whitehaven/wild-harp-build/presite_checklist.md

# Base Checklist

To be completed before leaving to the airfield.

## Materials

- [ ] plane body, fully assembled
- [ ] primary battery
- [ ] Radio control
  - [ ] battery
- [ ] FPV goggles
  - [ ] battery
- [ ] laptop
- [ ] SiK transmitter

### Optional

- [ ] charger
  - [ ] appropriate `XT60` hookup leads
- [ ] 12V support battery
  - [ ] appropriate `XT60` hookup leads
- [ ] car battery terminal leads
  - [ ] appropriate `XT60` hookup leads
- [ ] USB-C cable

## Flight plan

- [ ] Weather/conditions checked and permissible
- [ ] Flight registered via LAANC
