whitehaven/wild-harp-build/airframe/nose/nose mount.SLDPRT

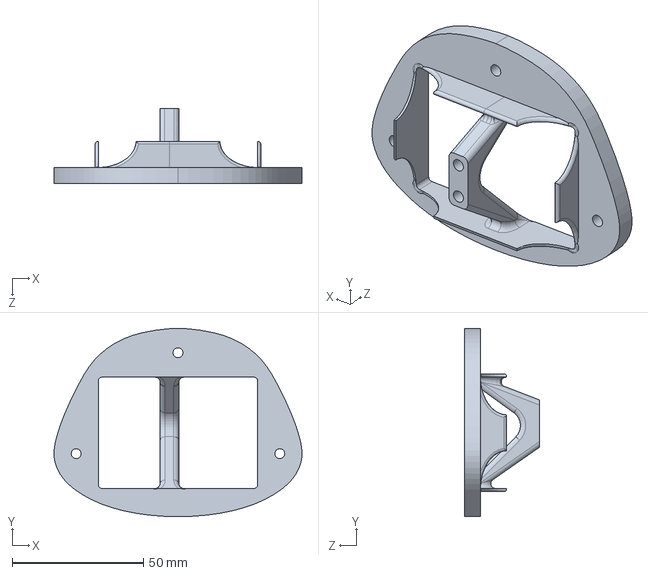
[picture p1: CAD file, 2024-09-02]
airframe/nose/nose mount.SLDPRT
94.3 x 71.6 x 28.4 mm
