whitehaven/wild-harp-build/fc_system/F405_mount.step

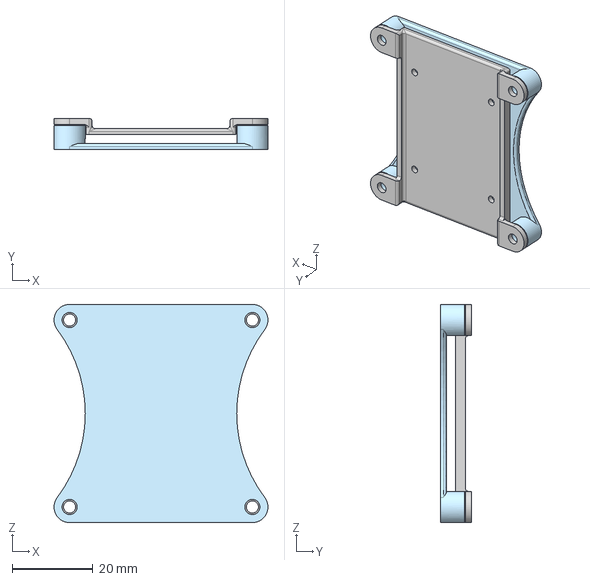
[picture p2: CAD file, 2024-07-30]
fc_system/F405_mount.step
53.0 x 7.73 x 54.1 mm
