whitehaven/wild-harp-build/fpv_system/vtx mount.SLDPRT

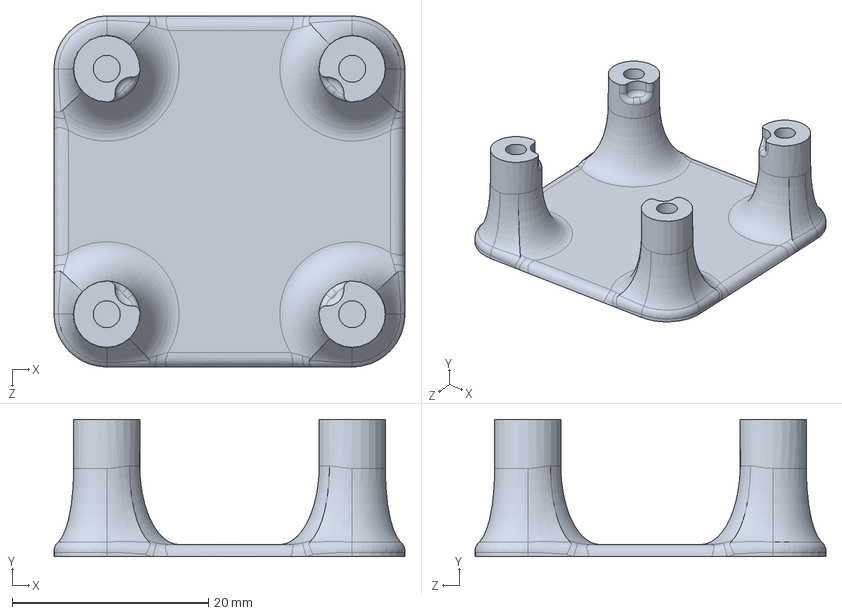
[picture p3: CAD file, 2024-08-24]
fpv_system/vtx mount.SLDPRT
35.8 x 14.0 x 35.8 mm
