whitehaven/wild-harp-build/airframe/motor_mount/spacer.SLDPRT

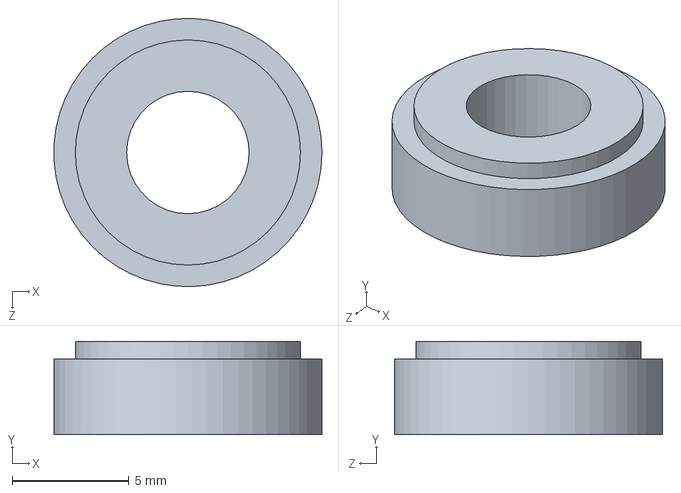
[picture p4: CAD file, 2024-08-18]
airframe/motor_mount/spacer.SLDPRT
11.5 x 4.00 x 11.5 mm
