whitehaven/wild-harp-build/airframe/nose/beak elliptical nose.SLDPRT

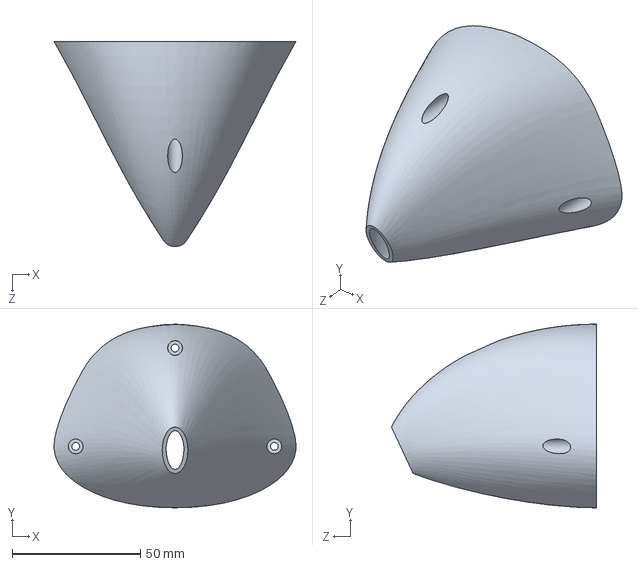
[picture p5: CAD file, 2024-09-01]
airframe/nose/beak elliptical nose.SLDPRT
94.4 x 71.6 x 80.0 mm
