whitehaven/wild-harp-build/fpv_system/camera mount.SLDPRT

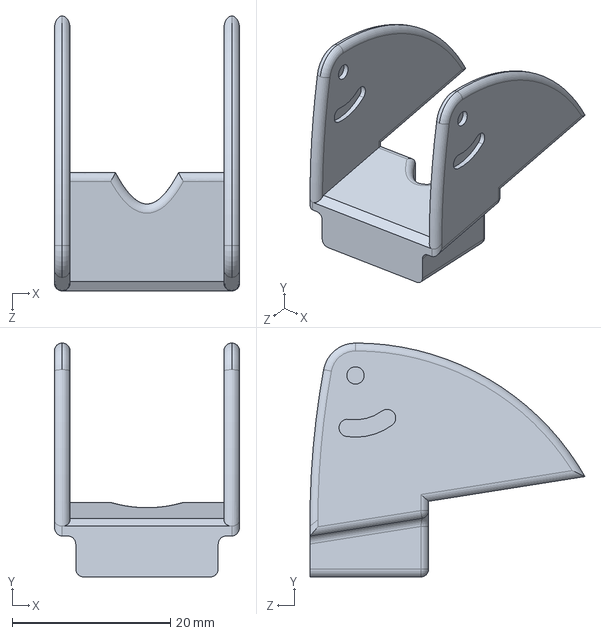
[picture p6: CAD file, 2024-08-01]
fpv_system/camera mount.SLDPRT
23.4 x 29.6 x 34.8 mm
