whitehaven/wild-harp-build/(list of files, cad)

Other CAD files:
airframe/nose/nose assembly.SLDASM
airframe/motor_mount/motor mount open.sldprt
airframe/motor_mount/motor mount open.3mf
airframe/motor_mount/spacer.3MF
airframe/nose/beak elliptical nose.3MF
airframe/nose/nose mount pattern.SLDDRW
airframe/nose/nose mount.3MF
fc_system/F405_mount.3mf
fpv_system/camera mount.3MF
fpv_system/vtx mount.3MF
