whitehaven/wild-harp-build/airframe/nose/nose mount pattern.pdf

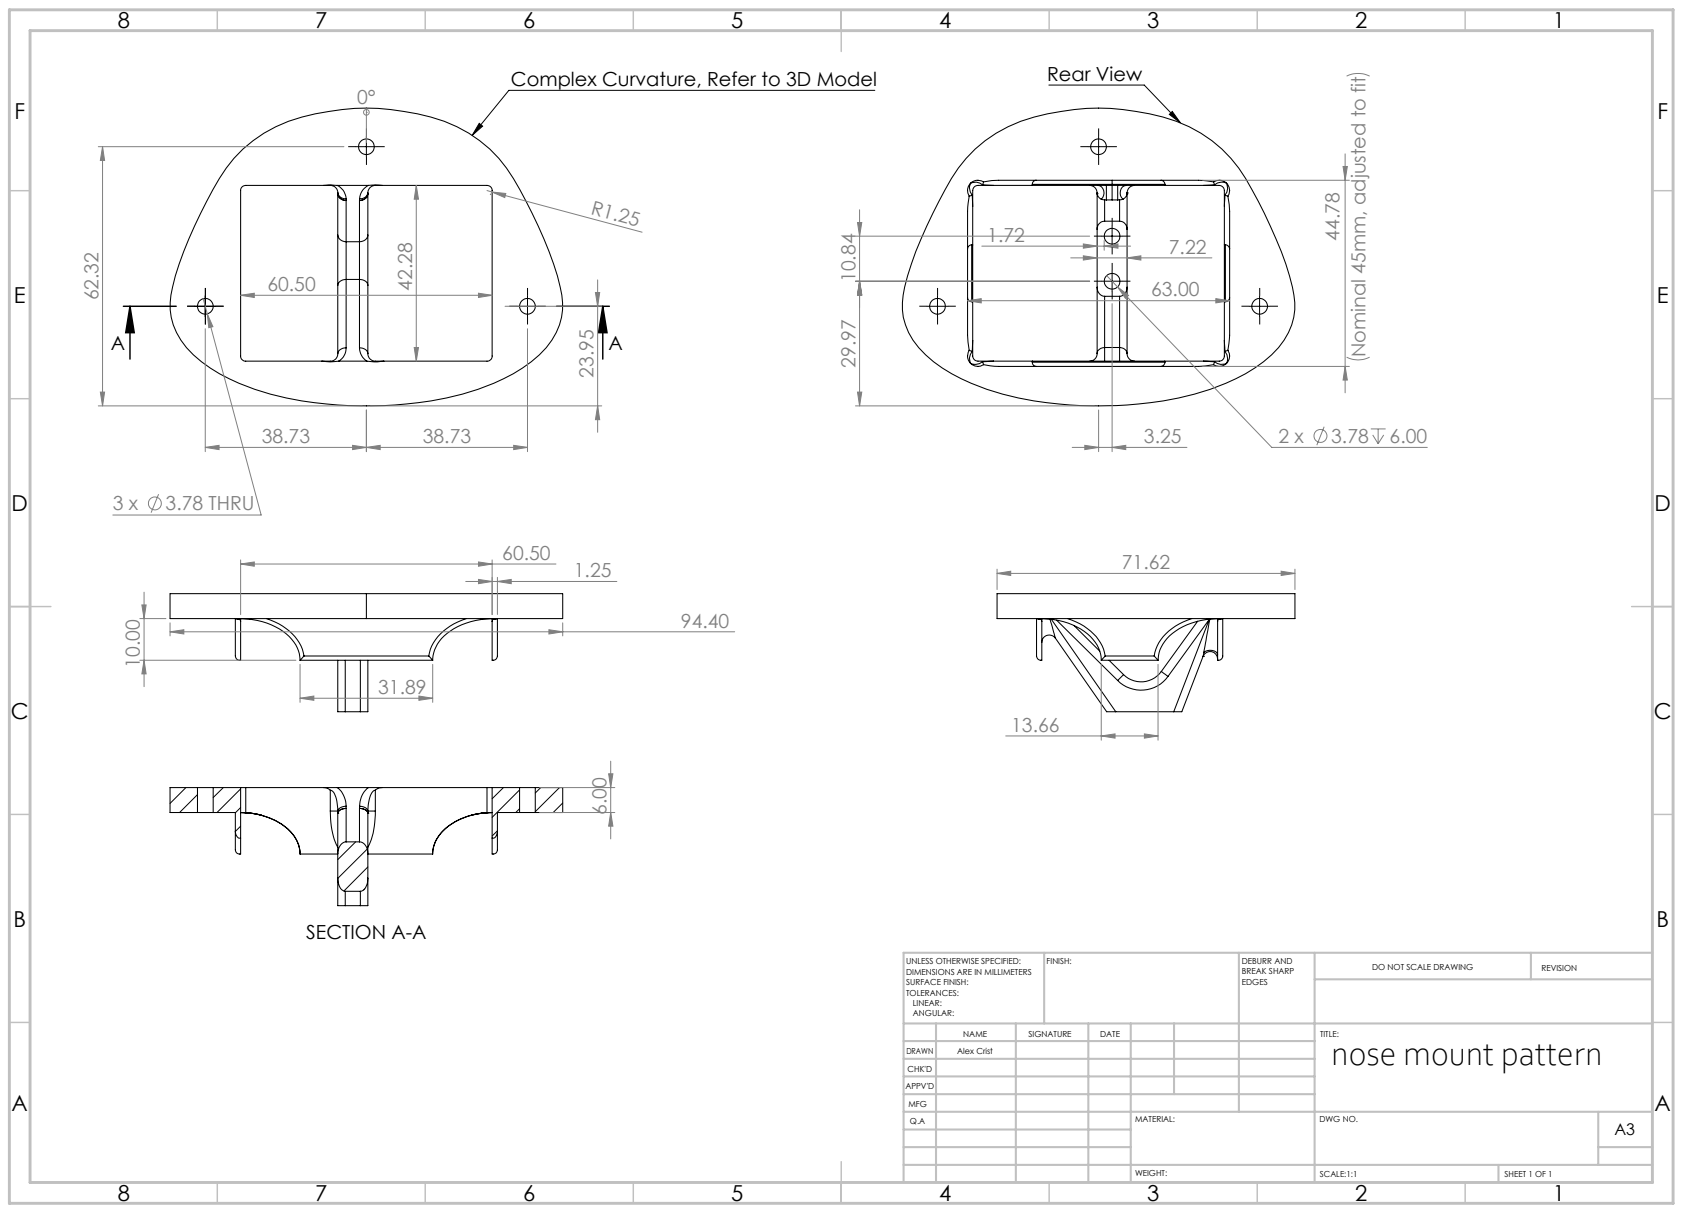
[picture p7: page 1]
3 x 3.78 THRU; Rear View; SECTION A-A; FINISH:; DEBURR AND; BREAK SHARP; DO NOT SCALE DRAWING; REVISION; SCALE:1:1; SHEET 1 OF 1

Complex Curvature, Refer to 3D Model

Nominal 45mm, adjusted to fit

UNLESS OTHERWISE SPECIFIED:
DIMENSIONS ARE IN MILLIMETERS
SURFACE FINISH:
TOLERANCES:
LINEAR:
ANGULAR:

DRAWN | Alex Crist

NAME | SIGNATURE | DATE | | | | TITLE: nose mount pattern

CHK'D
APPV'D
MFG
Q.A | | | | MATERIAL: | DWG NO. | A3
