whitehaven/wild-harp-build/avionics/ardupilot_wild_harp.param

BATT_AMP_OFFSET,0
BATT_AMP_PERVLT,50
BATT_ARM_MAH,0
BATT_ARM_VOLT,0
BATT_CAPACITY,3300
BATT_CRT_MAH,0
BATT_CRT_VOLT,0
BATT_CURR_PIN,11
BATT_FS_CRT_ACT,0
BATT_FS_LOW_ACT,1
BATT_FS_VOLTSRC,0
BATT_LOW_MAH,200
BATT_LOW_TIMER,10
BATT_LOW_VOLT,0
BATT_MONITOR,4
BATT_OPTIONS,0
BATT_SERIAL_NUM,-1
BATT_VLT_OFFSET,0
BATT_VOLT_MULT,11.05
BATT_VOLT_PIN,10
BATT2_MONITOR,0
BATT3_MONITOR,0
BATT4_MONITOR,0
BATT5_MONITOR,0
BATT6_MONITOR,0
BATT7_MONITOR,0
BATT8_MONITOR,0
BATT9_MONITOR,0
FLTMODE_CH,11
FLTMODE_GCSBLOCK,0
FLTMODE1,5
FLTMODE2,7
FLTMODE3,4
FLTMODE4,12
FLTMODE5,13
FLTMODE6,0
INS_GYRO_FILTER,20
INS_HNTCH_ENABLE,0
SERIAL0_BAUD,115
SERIAL0_PROTOCOL,2
SERIAL1_BAUD,57
SERIAL1_OPTIONS,0
SERIAL1_PROTOCOL,23
SERIAL2_BAUD,57
SERIAL2_OPTIONS,0
SERIAL2_PROTOCOL,2
SERIAL3_BAUD,230
SERIAL3_OPTIONS,0
SERIAL3_PROTOCOL,5
SERIAL4_BAUD,57
SERIAL4_OPTIONS,0
SERIAL4_PROTOCOL,2
SERIAL5_BAUD,115
SERIAL5_OPTIONS,0
SERIAL5_PROTOCOL,42
SERIAL6_BAUD,57
SERIAL6_OPTIONS,0
SERIAL6_PROTOCOL,2
SERVO1_FUNCTION,70
SERVO1_MAX,2000
SERVO1_MIN,1000
SERVO1_REVERSED,0
SERVO1_TRIM,1000
SERVO2_FUNCTION,0
SERVO2_MAX,1900
SERVO2_MIN,1100
SERVO2_REVERSED,0
SERVO2_TRIM,1500
SERVO3_FUNCTION,78
SERVO3_MAX,2000
SERVO3_MIN,1000
SERVO3_REVERSED,1
SERVO3_TRIM,1503
SERVO4_FUNCTION,77
SERVO4_MAX,2000
SERVO4_MIN,1000
SERVO4_REVERSED,0
SERVO4_TRIM,1445
SERVO5_FUNCTION,0
SERVO5_MAX,1900
SERVO5_MIN,1100
SERVO5_REVERSED,0
SERVO5_TRIM,1500
SERVO6_FUNCTION,0
SERVO6_MAX,1900
SERVO6_MIN,1100
SERVO6_REVERSED,0
SERVO6_TRIM,1500
SERVO7_FUNCTION,0
SERVO7_MAX,1900
SERVO7_MIN,1100
SERVO7_REVERSED,0
SERVO7_TRIM,1500
SERVO8_FUNCTION,0
SERVO8_MAX,1900
SERVO8_MIN,1100
SERVO8_REVERSED,0
SERVO8_TRIM,1500
SERVO9_FUNCTION,0
SERVO9_MAX,1900
SERVO9_MIN,1100
SERVO9_REVERSED,0
SERVO9_TRIM,1500
