whitehaven/wild-harp-build/radiomaster_boxer_config/model00.yml

semver: 2.8.4
header: 
   name: "Wild Harp"
timers: 
   0:
      start: 0
      swtch: "NONE"
      value: 4185
      mode: OFF
      countdownBeep: 0
      minuteBeep: 0
      persistent: 0
      countdownStart: 0
      showElapsed: 0
      name: ""
telemetryProtocol: 0
thrTrim: 0
noGlobalFunctions: 0
displayTrims: 0
ignoreSensorIds: 0
trimInc: 0
disableThrottleWarning: 0
displayChecklist: 0
extendedLimits: 1
extendedTrims: 0
throttleReversed: 0
enableCustomThrottleWarning: 0
disableTelemetryWarning: 0
customThrottleWarningPosition: 0
beepANACenter: 0
mixData: 
 -
   weight: 100
   destCh: 0
   srcRaw: I3
   carryTrim: 0
   mixWarn: 0
   mltpx: ADD
   offset: 0
   swtch: "NONE"
   flightModes: 000000000
   delayUp: 0
   delayDown: 0
   speedUp: 0
   speedDown: 0
   name: ""
 -
   weight: 100
   destCh: 1
   srcRaw: I1
   carryTrim: 0
   mixWarn: 0
   mltpx: ADD
   offset: 0
   swtch: "NONE"
   flightModes: 000000000
   delayUp: 0
   delayDown: 0
   speedUp: 0
   speedDown: 0
   name: ""
 -
   weight: 100
   destCh: 2
   srcRaw: I2
   carryTrim: 0
   mixWarn: 0
   mltpx: ADD
   offset: 0
   swtch: "NONE"
   flightModes: 000000000
   delayUp: 0
   delayDown: 0
   speedUp: 0
   speedDown: 0
   name: ""
 -
   weight: 100
   destCh: 3
   srcRaw: I0
   carryTrim: 0
   mixWarn: 0
   mltpx: ADD
   offset: 0
   swtch: "NONE"
   flightModes: 000000000
   delayUp: 0
   delayDown: 0
   speedUp: 0
   speedDown: 0
   name: ""
 -
   weight: 100
   destCh: 4
   srcRaw: SA
   carryTrim: 0
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
   2:
      val: 85
   3:
      val: -11
   4:
      val: 33
   156:
      val: -100
   159:
      val: 100
   160:
      val: -2
   161:
      val: 2
thrTraceSrc: Thr
switchWarningState: AuBuCuDuEuFu
rssiSource: none
rfAlarms: 
   warning: 45
   critical: 42
thrTrimSw: 0
potsWarnMode: WARN_OFF
jitterFilter: ON
moduleData: 
   0:
      type: TYPE_CROSSFIRE
      subType: 0
      channelsStart: 0
      channelsCount: 16
      failsafeMode: NOT_SET
      mod: 
         crsf: 
            telemetryBaudrate: 0
inputNames: 
   0:
      val: "Rud"
   1:
      val: "Ele"
   2:
      val: "Thr"
   3:
      val: "Ail"
   4:
      val: "P1"
   5:
      val: "P2"
   6:
      val: "Mod"
potsWarnEnabled: 0
screens: 
   0:
      type: SCRIPT
      u: 
         script: 
            file: "yaapu7"
view: 0
modelRegistrationID: "*\x15*\x15!\x03%\x07"
