whitehaven/wild-harp-build/(commit log)

2024-07-30 Add first dump of ardupilot params
    [ardupilot_wild_harp.param]
2024-07-30 added CAD files for FC mount
    [hive_mount.3mf, hive_mount.step]
2024-08-01 reorganize to avionics
    [ardupilot_wild_harp.param]
2024-08-01 reorganize to fc_sysystem
    [F405_mount.3mf, F405_mount.step]
2024-08-01 completed VTX mount, printed succesfully
    [VTX_mount.step, VTX_mount.x_t]
2024-08-01 completed and printed camera mount
    [camera mount.3MF, camera mount.SLDPRT, camera mount.STEP]
2024-08-02 rebuilt and correctly configured servos
    [ardupilot_wild_harp.param]
2024-08-09 add message to OSD, doesn't look right
    [ardupilot_wild_harp.param]
2024-08-09 add BLHeli_s passthrough support
    [ardupilot_wild_harp.param]
2024-08-09 shorter/closer takeoff
    [ardupilot_wild_harp.param]
2024-08-09 add utility file to allow esc passthrough
    [ardupilot_wild_harp_dshot_access.param]
2024-08-11 add SW base file for vtx mount which was missed
    [vtx mount.SLDPRT]
2024-08-18 added missing 3MF files
    [F405_mount.3mf, vtx mount.3MF]
2024-08-18 OSD reformat for smaller screen which was showing up
    [ardupilot_wild_harp.param]
2024-08-18 FC control of VTX enabled, unclear if working yet
    [ardupilot_wild_harp.param]
2024-08-18 initial tkoff/landing settings tried
    [ardupilot_wild_harp.param]
2024-08-18 final control settings before maiden 01
    [ardupilot_wild_harp.param]
2024-08-18 return to PMW ESC control
    [ardupilot_wild_harp.param]
2024-08-18 upgraded shorter VTX mount with correct contours for 20x20 protrusions
    [vtx mount.3MF, vtx mount.SLDPRT]
2024-08-18 spacer for pusher prop mounting
    [spacer.3MF, spacer.SLDPRT]
2024-08-21 add radio configuration
    [BOXER.cfg]
2024-08-24 PIDs from first tuning
    [ardupilot_wild_harp.param]
2024-08-24 working osd/vtx settings
    [ardupilot_wild_harp.param]
2024-08-24 odds and ends settings from flight 002, status update
    [ardupilot_wild_harp.param]
2024-08-24 new new VTX
    [vtx mount.SLDPRT]
2024-08-28 deactivate airspeed sensor for now
    [ardupilot_wild_harp.param]
2024-08-28 terrain enabled with sizing, untested as yet
    [ardupilot_wild_harp.param]
2024-08-29 ADC on for this profile only
2024-09-01 add FDM nose mount and beak-ellipse nose
    [beak elliptical nose.3MF, beak elliptical nose.SLDPRT, nose assembly.SLDASM, nose mount.3MF, nose mount.SLDPRT]
2024-09-01 flight log 2024-09-01
    [ardupilot_wild_harp.param]
2024-09-01 OSD refomat for better spacing and wind estimation
    [ardupilot_wild_harp.param]
2024-09-02 9/2 update including nose mount spec added
    [nose mount pattern.SLDDRW, nose mount.SLDPRT]
2024-09-02 remove derivative VTX modeling files missed from earlier
    [VTX_mount.step, VTX_mount.x_t, camera mount.STEP]
2024-09-06 9/3 flight and changes
    [ardupilot_wild_harp.param]
2024-09-07 new MAGfit calibration to fix persistent orientation error
    [ardupilot_wild_harp.param]
2024-09-07 replace FBWB with Cruise mode
    [ardupilot_wild_harp.param]
2024-09-07 remove read-only params so we don't keep loading them
    [ardupilot_wild_harp.param]
2024-09-09 added new motor mount
    [motor mount open.3mf, motor mount open.sldprt]
2024-09-09 added Sik telemetry radio (when I actually did)
    [ardupilot_wild_harp.param]
2024-09-09 put back servo 12 function since this was used for status neopixel1
    [ardupilot_wild_harp.param]
2024-09-09 cut down dshot activation method to only the param that changes
    [ardupilot_wild_harp_dshot_access.param]
2024-09-09 compass fit updated from logs
    [ardupilot_wild_harp.param]
2024-09-18 some last details from last flight I didn't record
    [ardupilot_wild_harp.param, dshot_access.param, excluded_params.txt]
2024-09-18 osd improved to show cell voltages (rest volts for max accuracy)
    [ardupilot_wild_harp.param]
2024-09-18 add checks for vital components before launch
    [ardupilot_wild_harp.param]
2024-09-18 add upper left 2-position switch as RTL on/return to prior function
    [ardupilot_wild_harp.param]
2024-09-19 good scary flight, retuning got rid of roll oscillation
    [ardupilot_wild_harp.param]
2024-09-25 move VTX config files to fpv folder, reorganize
    [BOXER.cfg, beak elliptical nose.3MF, beak elliptical nose.SLDPRT, motor mount open.3mf, motor mount open.sldprt, nose assembly.SLDASM, nose mount pattern.SLDDRW, nose mount.3MF]
